pdulab/7segment_driver_ltc4627_2623/3D_models/LTC-2623Jx.step

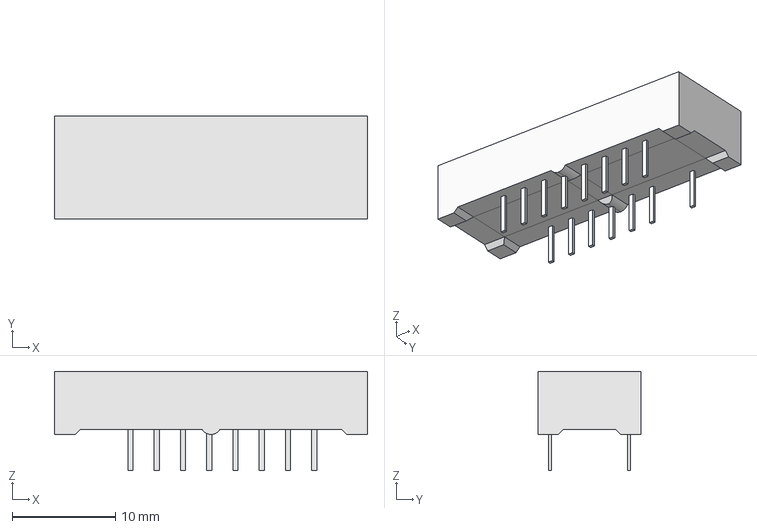
[picture p1: CAD file, 2023-11-27]
3D_models/LTC-2623Jx.step
30.3 x 10.0 x 9.60 mm
