pdulab/7segment_driver_ltc4627_2623/KiCad/7seg_plus_plus.kicad_pcb

## KiCad design KiCad/7seg_plus_plus.kicad_pcb (2023-11-27)

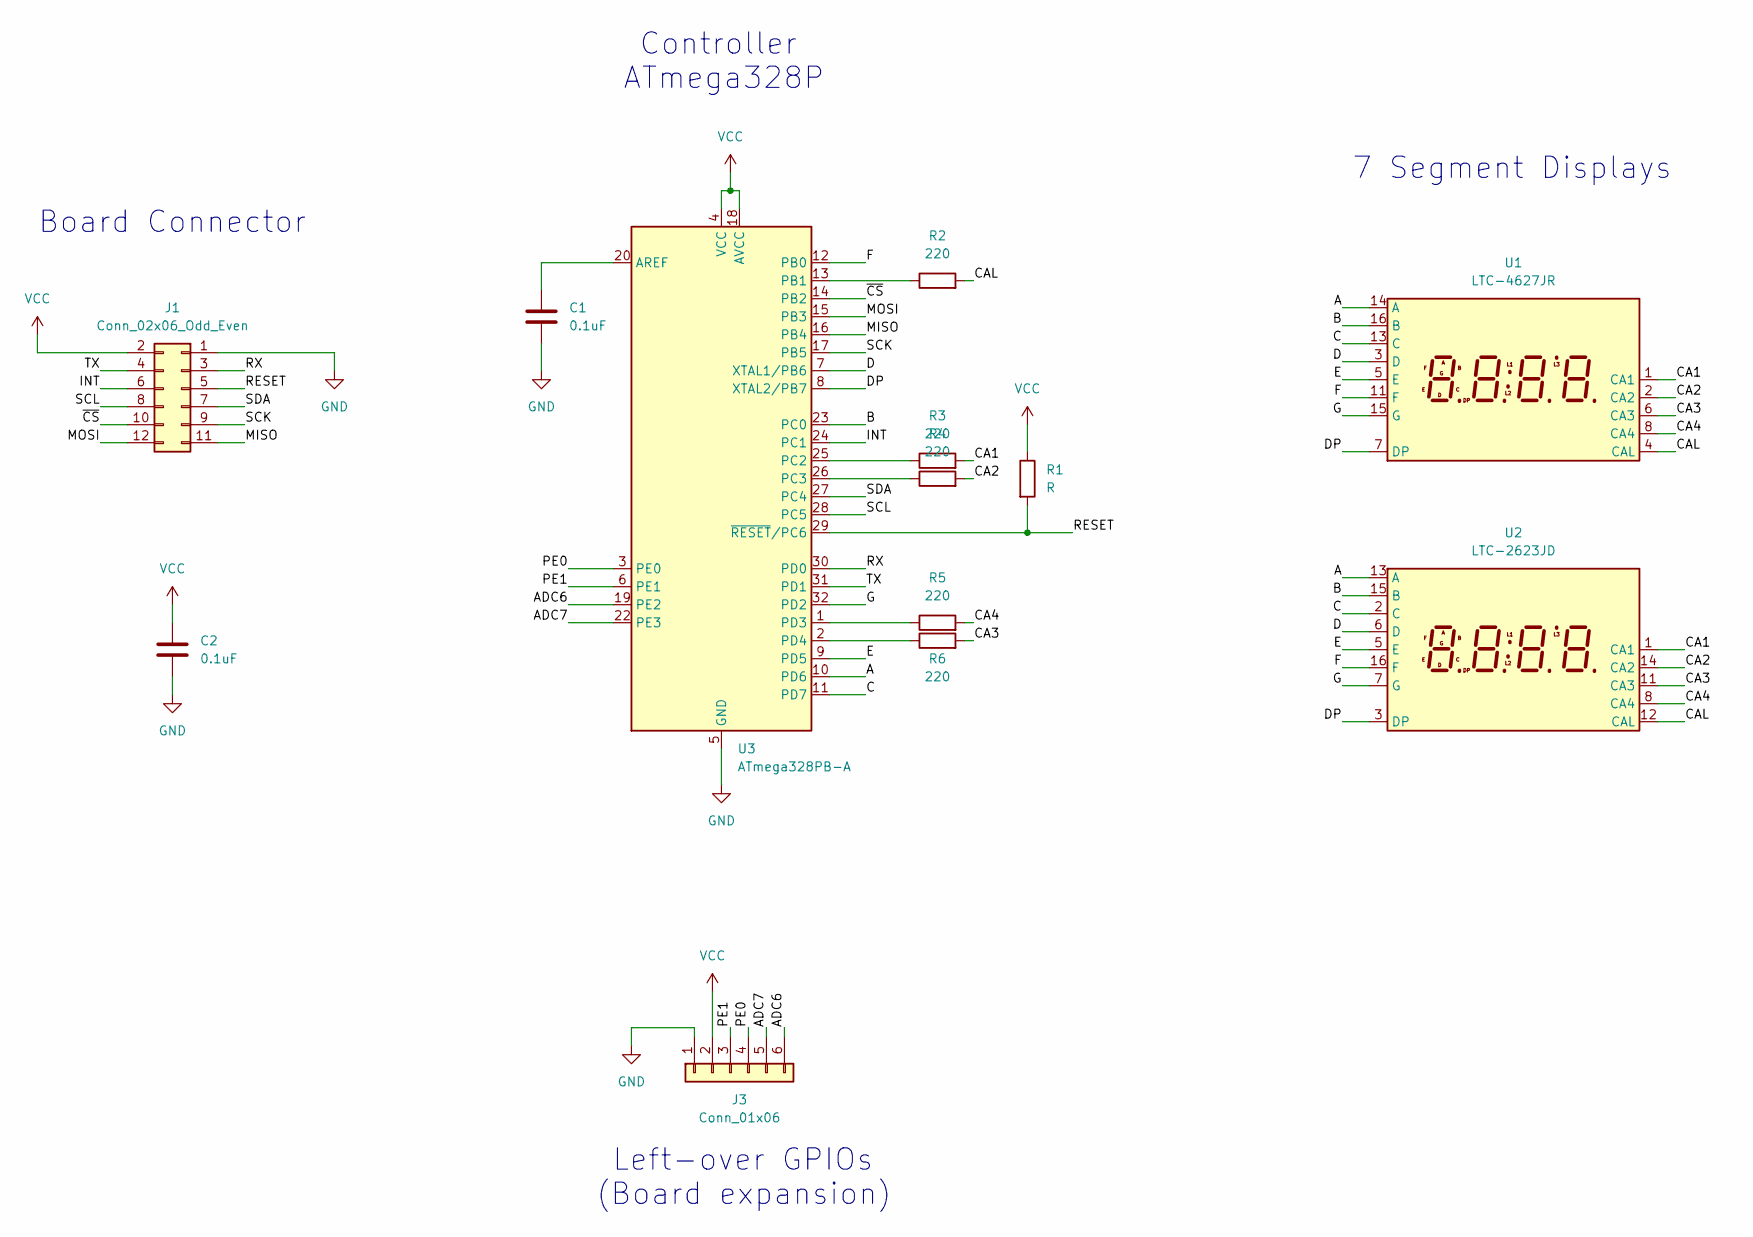
[picture p2: schematic 7seg_plus_plus.kicad_sch]

Parts:
C1, C2: 0.1uF; C_1206_3216Metric_Pad1.33x1.80mm_HandSolder
J1: Conn_02x06_Odd_Even; PinHeader_2x06_P2.54mm_Vertical
J3: Conn_01x06; PinHeader_1x06_P2.54mm_Vertical
R1: R; R_1206_3216Metric_Pad1.30x1.75mm_HandSolder
R2, R3, R4, R5, R6: 220; R_1206_3216Metric_Pad1.30x1.75mm_HandSolder
U1: LTC-4627JR; LTC-4627Jx
U2: LTC-2623JD; LTC-2623Jx
U3: ATmega328PB-A; TQFP-32_7x7mm_P0.8mm

Connections:
/A: U1.14 (A), U2.13 (A), U3.10 (PD6)
/ADC6: J3.6, U3.19 (PE2)
/ADC7: J3.5, U3.22 (PE3)
/B: U1.16 (B), U2.15 (B), U3.23 (PC0)
/C: U1.13 (C), U2.2 (C), U3.11 (PD7)
/CA1: R3.2, U1.1 (CA1), U2.1 (CA1)
/CA2: R4.2, U1.2 (CA2), U2.14 (CA2)
/CA3: R6.2, U1.6 (CA3), U2.11 (CA3)
/CA4: R5.2, U1.8 (CA4), U2.8 (CA4)
/CAL: R2.2, U1.4 (CAL), U2.12 (CAL)
/D: U1.3 (D), U2.6 (D), U3.7 (XTAL1/PB6)
/DP: U1.7 (DP), U2.3 (DP), U3.8 (XTAL2/PB7)
/E: U1.5 (E), U2.5 (E), U3.9 (PD5)
/F: U1.11 (F), U2.16 (F), U3.12 (PB0)
/G: U1.15 (G), U2.7 (G), U3.32 (PD2)
/INT: J1.6, U3.24 (PC1)
/MISO: J1.11, U3.16 (PB4)
/MOSI: J1.12, U3.15 (PB3)
/PE0: J3.4, U3.3 (PE0)
/PE1: J3.3, U3.6 (PE1)
/RESET: J1.5, R1.2, U3.29 (~RESET/PC6)
/RX: J1.3, U3.30 (PD0)
/SCK: J1.9, U3.17 (PB5)
/SCL: J1.8, U3.28 (PC5)
/SDA: J1.7, U3.27 (PC4)
/TX: J1.4, U3.31 (PD1)
/~CS: J1.10, U3.14 (PB2)
GND: C1.2, C2.2, J1.1, J3.1, U3.5 (GND), U3.21 (GND)
unnamed: C1.1, U3.20 (AREF)
unnamed: R2.1, U3.13 (PB1)
unnamed: R3.1, U3.25 (PC2)
unnamed: R4.1, U3.26 (PC3)
unnamed: R5.1, U3.1 (PD3)
unnamed: R6.1, U3.2 (PD4)
VCC: C2.1, J1.2, J3.2, R1.1, U3.4 (VCC), U3.18 (AVCC)

Notes on the sheet:
Board Connector
Controller ATmega328P
Left-over GPIOs (Board expansion)
7 Segment Displays

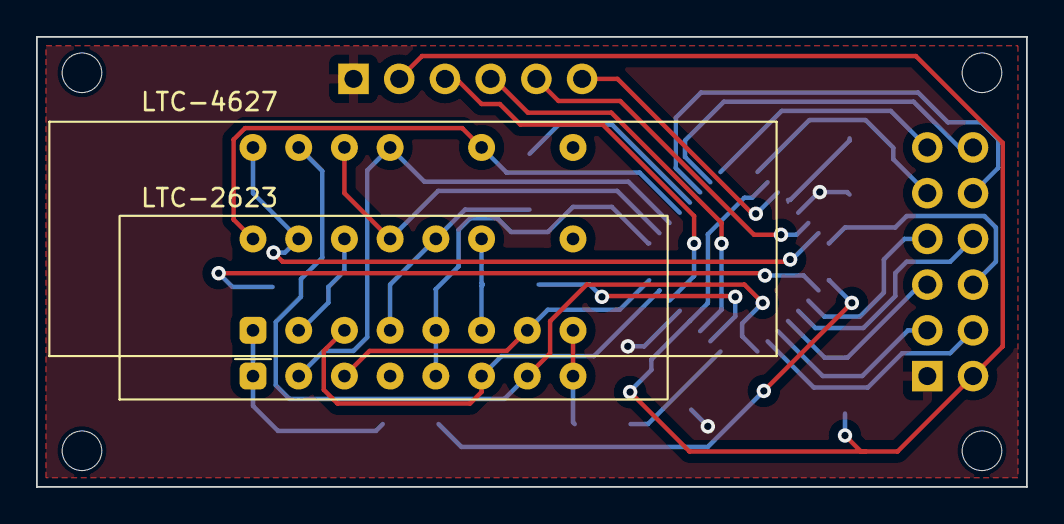
[picture p3: board 7seg_plus_plus.kicad_pcb from above]

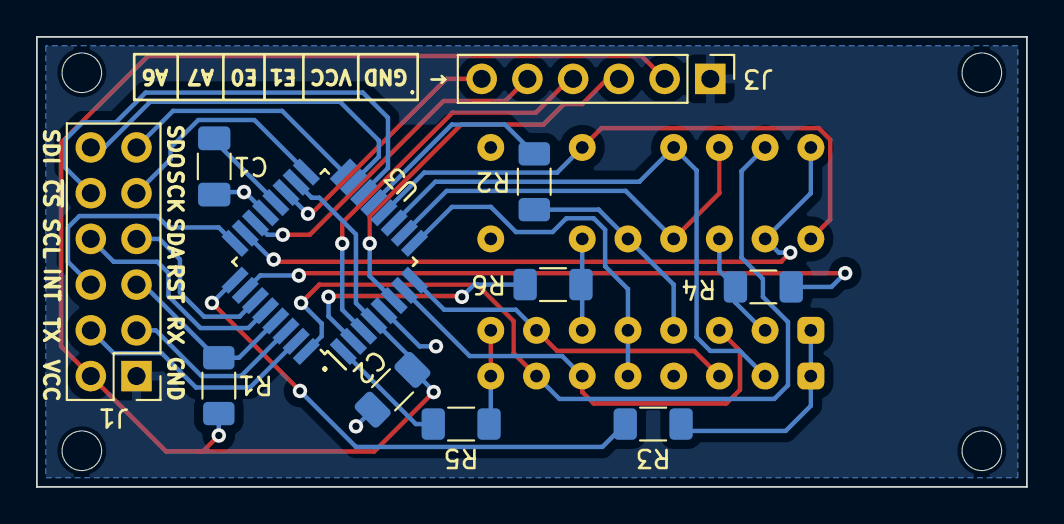
[picture p4: board 7seg_plus_plus.kicad_pcb from below]

Board: 2 copper layers, 55.0 x 25.0 mm, 13 parts (11 on the bottom side), 35 nets.
